Shisius/EyeMeterPCB/Interface/bom_interface_nextpcb.xls

 | Designator* | Quantity* | Manufacturer Part Number* | Manufacturer | Package/Footprint | Description | Procurement Type | Customer Note | HQ Part #
 | Required | Required | Required |  |  |  | Optional 1）Do not populate/install: DNP 2）Customer supplied part: C Learn more >
1 | C1,C2,C3 | 3 | C3216X5R1V226MTJ00E | TDK | 1206 | 22uF |  |  | CA0182043 | https://www.hqonline.com/product-detail/chip-capacitor--mlcc--tdk-c3216x5r1v226mtj00e-2500311338
2 | C4,C14,C29-C49, C54-C64,C82,C90-C92,C94-C96,C99-C102 | 45 | CC0402KRX5R9BB104 | Yageo | _0402 | 0.1uF |  |  | CA0173174 | https://www.hqonline.com/product-detail/chip-capacitor--mlcc--yageo-cc0402krx5r9bb104-2500230851
3 | C5,C11,C51,C68,C73,C74 | 6 | CL10A105KO8NNNC | Samsung | _0603 | 1uF |  |  | CA0000456 | https://www.hqonline.com/product-detail/chip-capacitor--mlcc--samsung-cl10a105ko8nnnc-2500015746
4 | C6,C8 | 2 | CL10A226MP8NUNE | Samsung | _0603 | 22uF |  |  | CA0135462 | https://www.hqonline.com/product-detail/chip-capacitor--mlcc--samsung-cl10a226mp8nune-2500415027
5 | C7 | 1 | - |  |  | 0.1uF | DNP
6 | C9,C10,C13,C88 | 4 | CL10A475KP8NNNC | Samsung | _0603 | 4.7uF |  |  | CA0001809 | https://www.hqonline.com/product-detail/chip-capacitor--mlcc--samsung-cl10a475kp8nnnc-2500015756
7 | C12 | 1 | CL10B332KB8NNNC | Samsung | _0603 | 3.3n |  |  | CA0000169 | https://www.hqonline.com/product-detail/chip-capacitor--mlcc--samsung-cl10b332kb8nnnc-2500216294
8 | C15,C17,C20,C24 | 4 | GRM31CR61A107MEA8L | Murata | 1206 | 100uF |  |  | CA0481664 | https://www.hqonline.com/product-detail/chip-capacitor--mlcc--murata-grm31cr61a107mea8l-2500350836
9 | C16,C18,C22,C27,C97,C98 | 6 | GRM31CR61A476ME15L | Murata | 1206 | 47uF |  |  | CA0135599 | https://www.hqonline.com/product-detail/chip-capacitor--mlcc--murata-grm31cr61a476me15l-2500218741
10 | C19,C21 | 2 | CL10C121JB8NNNC | Samsung | _0603 | 120pF |  |  | CA0000575 | https://www.hqonline.com/product-detail/chip-capacitor--mlcc--samsung-cl10c121jb8nnnc-2500222834
11 | C23,C25,C26,C28,C79,C80,C89,C93 | 8 | CL10A106MP8NNNC | Samsung | _0603 | 10uF |  |  | CA0135232 | https://www.hqonline.com/product-detail/chip-capacitor--mlcc--samsung-cl10a106mp8nnnc-2500414665
12 | C50 | 1 | - |  |  | 10uF | DNP
13 | C52,C53 | 2 | CC0402BRNPO9BN6R8 | Yageo | _0402 | 6.8pF |  |  | CA0161101 | https://www.hqonline.com/product-detail/chip-capacitor--mlcc--yageo-cc0402brnpo9bn6r8-2500237111
14 | C65-C67 | 3 | C3216X5R1E336MT000E | TDK | 1206 | 33u/10V |  |  | CA0182323 | https://www.hqonline.com/product-detail/chip-capacitor--mlcc--tdk-c3216x5r1e336mt000e-2500318962
15 | C69-C72,C75-C78 | 8 | CL05A224KP5NNNC | Samsung | _0402 | 220nF |  |  | CA0000676 | https://www.hqonline.com/product-detail/chip-capacitor--mlcc--samsung-cl05a224kp5nnnc-2500228710
16 | C81,C83-C87 | 6 | CL10A225KP8NNNC | Samsung | _0603 | 2.2uF |  |  | CA0001683 | https://www.hqonline.com/product-detail/chip-capacitor--mlcc--samsung-cl10a225kp8nnnc-2500014133
17 | D1 | 1 | 1N4148WS-7-F | DIODES | SOD-323 | DS0001850 |  |  | DS0001850 | https://www.hqonline.com/product-detail/switching-diodes--small-signal--diodes-1n4148ws-7-f-2500216079
18 | D2-D4,D7,D8 | 5 | PESD5V0S1ULD | Nexperia | SOD882D | CP0019779 |  |  | CP0019779 | https://www.hqonline.com/product-detail/esd-suppressor---tvs-diodes-nexperia-pesd5v0s1uld-315-2500304128
19 | D5,D6 | 2 | B5819WS-TP | MCC | SOD-323 | DS0002831 |  |  | DS0002831 | https://www.hqonline.com/product-detail/schottky-diode-mcc-b5819ws-tp-1023199290
20 | J1 | 1 | 208294-0020 | Molex | SMD | Pico EzMate 1.8mm 2pin |  |  |  | https://www.hqonline.com/product-detail/molex-208294-0020-1025833693
21 | J2 | 1 | 533980271 | Molex | SMD | PicoBlade 2pin Vertical |  |  | ZHLM0039770 | https://www.hqonline.com/product-detail/wire-to-board-connectors-molex-533980271-2500407000
22 | J3,J17 | 2 | 533980671 | Molex | SMD | PicoBlade 6pin Vertical |  |  | ZHLM0308526 | https://www.hqonline.com/product-detail/wire-to-board-connectors-molex-533980671-2500405430
23 | J4,J6,J18 | 3 |  |  |  |  | DNP
24 | J5 | 1 | AFC11-S20ICA-00 | JS | CONN_15.6X3MM_SM | FFC 20pin 0.5mm Vertical |  |  | CO0889517 | https://www.hqonline.com/product-detail/fpc---ffc-connectors-js-afc11-s20ica-00-2500245008
25 | J7,J8 | 2 | 0.5K-AS-20PWB | MSTCONN | CONN_15.65X4.4MM_SM |  |  |  | CO0887814 | https://www.hqonline.com/product-detail/fpc---ffc-connectors-mstconn-0-5k-as-20pwb-2500234409
26 | J9,J12 | 2 | 533980571 | Molex | SMD | PicoBlade 5pin Vertical |  |  | ZHLM0075958 | https://www.hqonline.com/product-detail/wire-to-board-connectors-molex-533980571-2500405775
27 | J10 | 1 | AFA07-S15FCA-00 | JS | CONN_22X5.3MM_SM | FFC 15pin 1.0mm Horizontal |  |  | CO0889558 | https://www.hqonline.com/product-detail/fpc---ffc-connectors-js-afa07-s15fca-00-2500245049
28 | J11 | 1 | HYC77-TF09-200 | 华宇创 | 盘 | Micro SD card socket |  |  | CO0895534 | https://www.hqonline.com/product-detail/sd---sim---tf-card-sockets-hyc-hyc77-tf09-200-1029273652
29 | J13,J14 | 2 | 533980471 | Molex | SMD | PicoBlade 4pin Vertical |  |  | CO0002528 | https://www.hqonline.com/product-detail/wire-to-board-connectors-molex-0533980471-2500221993
30 | J15 | 1 | 533981271 | Molex | SMD | PicoBlade 12pin Vertical |  |  | CO1194767 | https://www.hqonline.com/product-detail/wire-to-board-connectors-molex-533981271-2500394884
31 | J16 | 1 | DF52-5S-0.8H | HRS | P=0.8mm | Hirose 0.8mm 5pin |  |  | CO0908951 | https://www.hqonline.com/product-detail/idc-connectors-hrs-df52-5s-0-8h-21--1007358882
32 | L1,L2 | 2 | DFE252012P-R47M=P2 | Murata | 1008 | 470nH |  |  | IN0020648 | https://www.hqonline.com/product-detail/power-inductors-murata-dfe252012p-r47m=p2-2500415282
33 | L3 | 1 | IHLP4040DZER4R7M11 | Vishay | SMD,10.1x10.8mm | 4.7uH |  |  | IN0021282 | https://www.hqonline.com/product-detail/fixed-inductors-vishay-ihlp4040dzer4r7m11-1008710270
34 | L4,L5 | 2 | XFL4015-471MEC | Coilcraft | SMD,4x4mm | 470nH |  |  | ZHLM0226999 | https://www.hqonline.com/product-detail/power-inductors-coilcraft-xfl4015-471mec-2500415229
35 | R1,R15 | 2 | AC0603FR-07453KL | Yageo | _0603 | 453K |  |  | RE0204828 | https://www.hqonline.com/product-detail/chip-resistors-yageo-ac0603fr-07453kl-2500283017
36 | R2-R4,R42 | 4 |  |  |  |  | DNP
37 | R5,R6,R8,R13,R16,R18,R33 | 7 | AC0603FR-07100KL | Yageo | _0603 | 100K |  |  | RE0034867 | https://www.hqonline.com/product-detail/chip-resistors-yageo-ac0603fr-07100kl-2500274305
38 | R7,R9,R14,R19,R20,R21, R22,R23,R25,R26,R27,R28,R29,R30,R31,R35,R37,R38,R39 | 19 | AC0603FR-0710KL | Yageo | _0603 | 10K |  |  | RE0034865 | https://www.hqonline.com/product-detail/chip-resistors-yageo-ac0603fr-0710kl-2500274307
39 | R10 | 1 | AC0402FR-072R2L | Yageo | _0402 | 2R2 |  |  | RE0203558 | https://www.hqonline.com/product-detail/chip-resistors-yageo-ac0402fr-072r2l-1012707950
40 | R11 | 1 | AC0603FR-0773K2L | Yageo | _0603 | 73.2K |  |  | RE0204883 | https://www.hqonline.com/product-detail/chip-resistors-yageo-ac0603fr-0773k2l-2500283077
41 | R12 | 1 | AC0603FR-07562KL | Yageo | _0603 | 562K |  |  | RE0204850 | https://www.hqonline.com/product-detail/chip-resistors-yageo-ac0603fr-07562kl-2500283042
42 | R17 | 1 | AC0603FR-0775KL | Yageo | _0603 | 75K |  |  | RE0063344 | https://www.hqonline.com/product-detail/chip-resistors-yageo-ac0603fr-0775kl-2500283080
43 | R24 | 1 | CRCW06036K04FKEA | Vishay | _0603 | 6.04K |  |  | RE0046523 | https://www.hqonline.com/product-detail/chip-resistors-vishay-crcw06036k04fkea-2500314244
44 | R32 | 1 | CRCW060347K0FKEA | Vishay | _0603 | 47K |  |  | RE0210203 | https://www.hqonline.com/product-detail/chip-resistors-vishay-crcw060347k0fkea-2500335244
45 | R34 | 1 | AC0603FR-0722RL | Yageo | _0603 | 22R |  |  | RE0063347 | https://www.hqonline.com/product-detail/chip-resistors-yageo-ac0603fr-0722rl-2500274319
46 | R36,R40 | 2 | RTT020000FTH | RALEC | _0402 | 0R |  |  | RE0208784 | https://www.hqonline.com/product-detail/chip-resistors-ralec-rtt020000fth-2500329286
47 | R41 | 1 | RTT030000FTP | RALEC | _0603 | 0R |  |  | RE0207388 | https://www.hqonline.com/product-detail/chip-resistors-ralec-rtt030000ftp-2500320460
48 | U1 | 1 | TPS62480RNCR | TI | VQFN-16(2.5x3) |  |  |  | IC0339798 | https://www.hqonline.com/product-detail/dc-dc-power-supply-chips-ti-tps62480rncr-1009501988
49 | U2 | 1 | SIC438AED-T1-GE3 | Vishay | PowerPAK-MLP44-24L |  |  |  | PM0148764 | https://www.hqonline.com/product-detail/dc-dc-power-supply-chips-vishay-sic438aed-t1-ge3-1021199767
50 | U3,U4 | 2 | TPS62823DLCR | TI | QFN (8) |  |  |  | PM0174636 | https://www.hqonline.com/product-detail/dc-dc-power-supply-chips-ti-tps62823dlcr-2500408658
51 | U5 | 1 | W25Q128FVSIG | Winbond | SOIC8_208MIL |  |  |  | IC0142197 | https://www.hqonline.com/product-detail/flash-memories-winbond-w25q128fvsig-2500289322
52 | U6 | 1 | VL805-Q6 | VIA Labs | QFN68 8x8 mm
53 | U7 | 1 | TPS2062DR | TI | SOIC8 |  |  |  | IC0273860 | https://www.hqonline.com/product-detail/power-switches---load-switches-ti-tps2062dr-1-1014202762
54 | U8-U13,U16,U20-U23,U25 | 12 | TPD4E02B04DQAR | TI | USON-10 |  |  |  | CP0003956 | https://www.hqonline.com/product-detail/esd-suppressor---tvs-diodes-ti-tpd4e02b04dqar-1036113975
55 | U14,U15,U19,U26 | 4 | TPD4E05U06DQAR | TI | USON10_2.5X1MM |  |  |  | CP0003927 | https://www.hqonline.com/product-detail/esd-suppressor---tvs-diodes-ti-tpd4e05u06dqar-2500216963
56 | U17 | 1 | CS42L42-CNZR | Cirrus Logic | 48-pin QFN
57 | U18 | 1 | TPD1E05U06DPYR | TI | X1SON2_1X0.6MM |  |  |  | CP0003571 | https://www.hqonline.com/product-detail/esd-suppressor---tvs-diodes-ti-tpd1e05u06dpyr-2500288724
58 | U24 | 1 | TPS2061CDBVR | TI | SOT-23-5 |  |  |  | IC0279848 | https://www.hqonline.com/product-detail/power-switches---load-switches-ti-tps2061cdbvr-1002595270
59 | U27 | 1 | TXS0102DQE | TI | X2SON8_1.4X1MM |  |  |  | IC0132488 | https://www.hqonline.com/product-detail/translators--level-shifters-ti-txs0102dqer-2500345757
60 | U28 | 3 | DF40C-100DS-0.4V(51) | HRS | CONN_22.6X2.88_SM | Hirose 100pin CM5
61 | Y1 | 1 | ECS-250-8-33B-CTN-TR | ECS Inc. | 3.2 x 2.5 x 0.8 mm |  |  |  | CR0312679
