Shisius/EyeMeterPCB/Interface/interface.kicad_sch

## KiCad design Interface/interface.kicad_sch (2025-08-15)

Schematic: interface.kicad_sch

Parts:
C1, C2, C3: 22u/35V; C_1206_3216Metric_Pad1.33x1.80mm_HandSolder
C4, C14, C29, C30, C31, C32, C33, C34, C35, C36, C37, C38, C39, C40, C41, C46, C47, C48, C49, C54, C63, C64: 0.1u; C_0402_1005Metric_Pad0.74x0.62mm_HandSolder
C5, C11, C51: 1u; C_0603_1608Metric_Pad1.08x0.95mm_HandSolder
C6, C8: 22u; C_0603_1608Metric_Pad1.08x0.95mm_HandSolder
C7: 0.1u; C_0402_1005Metric_Pad0.74x0.62mm_HandSolder; not fitted
C9, C10, C13: 4.7u; C_0603_1608Metric_Pad1.08x0.95mm_HandSolder
C12: 3.3n; C_0603_1608Metric_Pad1.08x0.95mm_HandSolder
C15, C17, C20, C24: 100u; C_1206_3216Metric_Pad1.33x1.80mm_HandSolder
C16, C18, C22, C27: 47u; C_1206_3216Metric_Pad1.33x1.80mm_HandSolder
C19, C21: 120p; C_0603_1608Metric_Pad1.08x0.95mm_HandSolder
C23, C25, C26, C28: 10u; C_0603_1608Metric_Pad1.08x0.95mm_HandSolder
C42, C43, C44, C45, C55, C56, C57, C58, C59, C60, C61, C62: 0.1u; C_0402_1005Metric
C50: 10u; C_0603_1608Metric_Pad1.08x0.95mm_HandSolder; not fitted
C52, C53: 6.8p; C_0402_1005Metric_Pad0.74x0.62mm_HandSolder
C65, C66, C67: 33u/10V; C_1206_3216Metric_Pad1.33x1.80mm_HandSolder
D1: 1N4148WS; D_SOD-323
D2, D3, D4: PESD5V0S1ULD; D_SOD-882D
J1: Conn_01x02_Pin; Molex_Pico-EZmate_208294-0002_1x02-1MP_P1.80mm
J2: Conn_01x02_Pin; Molex_PicoBlade_53398-0271_1x02-1MP_P1.25mm_Vertical
J3: Conn_01x06_Pin; Molex_PicoBlade_53398-0671_1x06-1MP_P1.25mm_Vertical
J4: USB3_IPEX
J5: Conn_01x20_Pin; JUSHUO_AFC11-S20ICA-00_1x20-1MP_P0.5mm_Vertical
J6: Conn_01x19_Pin; VUSB3-V-TH-19-MBH_VALCON; not fitted
L1, L2: 470n; L_1008_2520Metric_Pad1.43x2.20mm_HandSolder
L3: 4.7u; L_Vishay_IHLP-4040
L4, L5: 470n; L_Coilcraft_XFL4015
R1: 453K?; R_0603_1608Metric_Pad0.98x0.95mm_HandSolder
R2, R4: 100k; R_0603_1608Metric_Pad0.98x0.95mm_HandSolder; not fitted
R3: 2.8k; R_0603_1608Metric_Pad0.98x0.95mm_HandSolder; not fitted
R5, R6: 100k; R_0603_1608Metric_Pad0.98x0.95mm_HandSolder
R7, R9, R19, R20, R21, R22, R23, R25, R26, R27, R28: 10K; R_0603_1608Metric_Pad0.98x0.95mm_HandSolder
R8, R13, R16, R18: 100K; R_0603_1608Metric_Pad0.98x0.95mm_HandSolder
R10: 2R2; R_0402_1005Metric_Pad0.72x0.64mm_HandSolder
R11: 73.2k; R_0603_1608Metric_Pad0.98x0.95mm_HandSolder
R12: 562K; R_0603_1608Metric_Pad0.98x0.95mm_HandSolder
R14: 10k; R_0603_1608Metric_Pad0.98x0.95mm_HandSolder
R15: 453K; R_0603_1608Metric_Pad0.98x0.95mm_HandSolder
R17: 75K; R_0603_1608Metric_Pad0.98x0.95mm_HandSolder
R24: 6.04K; R_0603_1608Metric_Pad0.98x0.95mm_HandSolder
U1: TPS62480; TPS62480_VQFN
U2: SIC438B; Vishay_PowerPAK_MLP44-24L_ThermalVias
U3, U4: TPS62823DLC; Texas_VSON-HR-8_1.5x2mm_P0.5mm
U5: W25Q128FVS; SOIC-8W_5.3x5.3mm_P1.27mm
U6: VL805; QFN-68-1EP_8x8mm_P0.4mm_EP5.2x5.2mm_ThermalVias
U7: TPS2062; SOIC-8_3.9x4.9mm_P1.27mm_HandSoldering
U8, U9, U10, U11, U12, U13: TPD4E02B04DQA/ESD73034D; USON-10_2.5x1.0mm_P0.5mm
Y1: Crystal_GND24; Crystal_SMD_3225-4Pin_3.2x2.5mm_HandSoldering

Connections:
+1.05V: C21.1, C26.1, C28.1, C30.1, C32.1, C35.1, C37.1, C39.1, C41.1, C47.1, C49.1, L5.2, R17.2, U6.3 (VCCA10SSRX34), U6.9 (VDD), U6.12 (VCCA10SSRX34), U6.29 (VDD), U6.45 (VDD), U6.54 (VCCA10SSRX12), U6.60 (VDD), U6.63 (VCCA10SSRX12)
+3.3V: C9.1, C19.1, C23.1, C25.1, C29.1, C31.1, C33.1, C34.1, C36.1, C38.1, C40.1, C46.1, C48.1, D1.1 (K), L4.2, R9.1, R15.2, R19.1, R20.1, R21.1, R22.1, R23.1, R25.1, R26.1, R27.1, R28.1, U4.7 (VIN), U5.8 (VCC), U6.6 (VCCA33SS34), U6.15 (VCCA33SS34), U6.23 (VCCA33PEX), U6.32 (VSUS33), U6.46 (VSUS33), U6.49 (VCCA33SSM), U6.57 (VCCA33SS12), U6.66 (VCCA33SS12)
+3.3V_RADXA: R1.2, R7.1
+4V: C10.1, C16.1, C18.1, C22.1, C27.1, L1.2, L2.2, R12.2, U1.16 (VO), U3.7 (VIN)
+5V: C6.1, C8.1, C15.1, C17.1, C20.1, C24.1, C54.1, J3.1, J3.2, J3.3, L3.2, R11.1, U1.3 (VIN1), U1.4 (EN), U1.9 (VIN2), U2.18 (V_{OUT}), U7.2 (IN)
EN: C7.1, J2.2, R2.2, R3.1, U2.19 (EN)
GND: C1.2, C2.2, C3.2, C4.2, C5.2, C6.2, C7.2, C8.2, C9.2, C10.2, C11.2, C12.2, C13.2, C15.2, C16.2, C17.2, C18.2, C20.2, C22.2, C23.2, C24.2, C25.2, C26.2, C27.2, C28.2, C29.2, C30.2, C31.2, C32.2, C33.2, C34.2, C35.2, C36.2, C37.2, C38.2, C39.2, C40.2, C41.2, C46.2, C47.2, C48.2, C49.2, C50.1, C51.2, C52.2, C53.2, C54.2, C63.2, C64.2, C65.2, C66.2, C67.2, D2.2 (A), D3.2 (A), D4.2 (A), J1.1, J3.4, J3.5, J3.6, J4.5 (GND), J4.8 (GND), J4.11 (GND), J4.12 (GND), J4.13 (GND), J4.14 (GND), J4.15 (GND), J4.16 (GND), J4.17 (GND), J5.9, J5.10, J5.15, J5.20, J6.4, J6.7, J6.10, J6.13, J6.16, R3.2, R5.2, R8.1, R13.1, R14.2, R16.1, R18.1, R24.2, U1.1 (PGND1), U1.5 (PG), U1.6 (VSEL), U1.8 (MODE), U1.11 (PGND2), U1.13 (AGND), U2.3 (P_{GND}), U2.4 (P_{GND}), U2.13 (P_{GND}), U2.16 (A_{GND}), U2.25 (A_{GND}), U2.27 (P_{GND}), U3.3 (AGND), U3.5 (PGND), U3.8 (PG), U4.3 (AGND), U4.5 (PGND), U4.8 (PG), U5.4 (GND), U6.69 (GNDPAD), U7.1 (GND), U8.3 (G), U8.8 (G), U9.3 (G), U9.8 (G), U10.3 (G), U10.8 (G), U11.3 (G), U11.8 (G), U12.3 (G), U12.8 (G), U13.3 (G), U13.8 (G), Y1.2, Y1.4
unnamed: C5.1, R4.1, R6.1, U2.15 (V_{DD})
unnamed: C11.1, R9.2, U4.1 (EN)
unnamed: C12.1, U1.12 (SS/TR)
unnamed: C13.1, U2.12 (V_{DRV})
unnamed: C14.1, U2.23 (BOOT)
unnamed: C14.2, R10.2
unnamed: C19.2, R15.1, R16.2, U3.2 (FB)
unnamed: C21.2, R17.1, R18.2, U4.2 (FB)
unnamed: C51.1, D1.2 (A), R23.2, U6.31 (PONRST#)
unnamed: C52.1, U6.47 (SSXI), Y1.1
unnamed: C53.1, U6.48 (SSXO), Y1.3
unnamed: L1.1, U1.2 (SW1)
unnamed: L2.1, U1.10 (SW2)
unnamed: L3.1, U2.5 (SW), U2.6 (SW), U2.7 (SW), U2.8 (SW), U2.9 (SW)
unnamed: L4.1, U3.6 (SW)
unnamed: L5.1, U4.6 (SW)
unnamed: R4.2, R5.1, U2.21 (MODE1)
unnamed: R6.2, U2.20 (MODE2)
unnamed: R7.2, R8.2, U3.1 (EN)
unnamed: R10.1, U2.24 (PHASE)
unnamed: R11.2, R14.1, U2.17 (FB)
unnamed: R12.1, R13.2, U1.14 (FB)
unnamed: R19.2, U5.7 (~HOLD/~RESET(IO_{3}))
unnamed: R20.2, U5.3 (~WP(IO_{2}))
unnamed: R21.2, U6.20 (PEXWAKE#)
unnamed: R22.2, U6.18 (SMI#)
unnamed: R24.1, U6.50 (SSREXT)
unnamed: U2.10 (GL), U2.11 (GL), U2.28 (GL)
unnamed: U5.1 (~CS), U6.34 (SPICS#)
unnamed: U5.2 (DO(IO_{1})), U6.33 (SPISO)
unnamed: U5.5 (DI(IO_{0})), U6.36 (SPISI)
unnamed: U5.6 (CLK), U6.35 (SPISCLK)
PCIe_CLK+: U6.21 (PEXCLK+)
PCIe_CLK-: U6.22 (PEXCLK-)
PCIe_CLK_nREQ: U6.30 (PEXCREQ#)
PCIe_RX+: C44.1
PCIe_RX-: C42.1
PCIe_TX+: C45.1
PCIe_TX-: C43.1
PCIe_nRST: C50.2, U6.19 (PEXRST#)
PEXRX0_CAP+: C45.2, U6.27 (PEXRX0+)
PEXRX0_CAP-: C43.2, U6.28 (PEXRX0-)
PEXTX0_CAP+: C44.2, U6.24 (PEXTX0+)
PEXTX0_CAP-: C42.2, U6.25 (PEXTX0-)
PG: J2.1, U2.14 (P_{GOOD})
SSRX1+: J5.13, J5.14, U6.55 (SSRX1+), U8.4 (IO3), U8.7 (NC)
SSRX1-: J5.11, J5.12, U6.56 (SSRX1-), U8.5 (IO4), U8.6 (NC)
SSRX2+: J4.7 (SSRX+), U6.64 (SSRX2+), U13.1 (IO1), U13.10 (NC)
SSRX2-: J4.6 (SSRX-), U6.65 (SSRX2-), U13.2 (IO2), U13.9 (NC)
SSRX3+: J6.2, U6.4 (SSRX3+), U10.4 (IO3), U10.7 (NC)
SSRX3-: J6.3, U6.5 (SSRX3-), U10.5 (IO4), U10.6 (NC)
SSRX4+: J6.17, U6.13 (SSRX4+), U12.1 (IO1), U12.10 (NC)
SSRX4-: J6.18, U6.14 (SSRX4-), U12.2 (IO2), U12.9 (NC)
SSTX1+: C55.2, J5.18, J5.19, U8.1 (IO1), U8.10 (NC)
SSTX1-: C59.2, J5.16, J5.17, U8.2 (IO2), U8.9 (NC)
SSTX1_CAP+: C55.1, U6.52 (SSTX1+)
SSTX1_CAP-: C59.1, U6.53 (SSTX1-)
SSTX2+: C56.2, J4.10 (SSTX+), U9.4 (IO3), U9.7 (NC)
SSTX2-: C60.2, J4.9 (SSTX-), U9.5 (IO4), U9.6 (NC)
SSTX2_CAP+: C56.1, U6.61 (SSTX2+)
SSTX2_CAP-: C60.1, U6.62 (SSTX2-)
SSTX3+: C57.2, J6.5, U10.1 (IO1), U10.10 (NC)
SSTX3-: C61.2, J6.6, U10.2 (IO2), U10.9 (NC)
SSTX3_CAP+: C57.1, U6.1 (SSTX3+)
SSTX3_CAP-: C61.1, U6.2 (SSTX3-)
SSTX4+: C58.2, J6.14, U11.4 (IO3), U11.7 (NC)
SSTX4-: C62.2, J6.15, U11.5 (IO4), U11.6 (NC)
SSTX4_CAP+: C58.1, U6.10 (SSTX4+)
SSTX4_CAP-: C62.1, U6.11 (SSTX4-)
TG_4VDCDC: R1.1, U1.7 (TG)
USB2D1+: J5.7, J5.8, U6.58 (USB2D1+), U9.1 (IO1), U9.10 (NC)
USB2D1-: J5.5, J5.6, U6.59 (USB2D1-), U9.2 (IO2), U9.9 (NC)
USB2D2+: J4.4 (D+), U6.67 (USB2D2+), U13.4 (IO3), U13.7 (NC)
USB2D2-: J4.3 (D-), U6.68 (USB2D2-), U13.5 (IO4), U13.6 (NC)
USB2D3+: J6.9, U6.7 (USB2D3+), U11.1 (IO1), U11.10 (NC)
USB2D3-: J6.8, U6.8 (USB2D3-), U11.2 (IO2), U11.9 (NC)
USB2D4+: J6.11, U6.16 (USB2D4+), U12.4 (IO3), U12.7 (NC)
USB2D4-: J6.12, U6.17 (USB2D4-), U12.5 (IO4), U12.6 (NC)
USBEN1: R25.2, U6.42 (USBHPE2#), U6.44 (USBHPE1#), U7.3 (~EN1)
USBEN2: R26.2, U6.38 (USBHPE4#), U6.40 (USBHPE3#), U7.4 (~EN2)
USBOC1: R28.2, U6.41 (USBHOC2#), U6.43 (USBHOC1#), U7.8 (~OC1)
USBOC2: R27.2, U6.37 (USBHOC4#), U6.39 (USBHOC3#), U7.5 (~OC2)
VBAT: C1.1, C2.1, C3.1, C4.1, J1.2, R2.1, U2.1 (V_{IN}), U2.2 (V_{IN}), U2.22 (V_{IN}), U2.26 (V_{IN})
VBUS1: C64.1, C65.1, C66.1, D2.1 (K), D3.1 (K), J4.1 (VBUS), J4.2 (VBUS), J5.1, J5.2, J5.3, J5.4, U7.7 (OUT1)
VBUS2: C63.1, C67.1, D4.1 (K), J6.1, J6.19, U7.6 (OUT2)

Notes on the sheet:
C_{AC-COUPLING} = (75-200)nF Close to U
3.3V
(3A=>50mil=1.27mm)
FCCM
or +5V
(1080 glass style) 0.0022", (2116 glass style) 0.0042", (7628 glass style) 0.0075”
6.5A
PCIe_1V05 is delayed by 10ms than DCDC_3V3 to start
CL10A106KQ8NNNC
+3.3V
Match the differential SS pair trace lengths within 0.12 mm (5 mils). Match the Hi-Speed (D+ and D–) signal trace lengths within 1.25 mm (50 mils). Adjust the Hi-Speed signal trace lengths near the USB receptacle, if necessary. Make adjustments for SS Rx signal trace lengths near the USB recept…
500kHz
PCIdif=100 Ohm
(5A=>110mil=2.794mm)
5A/pin
TESTEN - Test Mode Enable Do not connect for normal operation. Internal pull down.
Roger is the favorite dielectric material due to its low DK and DF value, low price, and less signal loss. FR-4 is only suitable for 1 GHz to 10 GHz frequency. In terms of DF(dielectric loss), DK (dielectric constant), and water absorption, Teflon is the best, but more expensive than FR-4. The Tefl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
Prepreg dielectric constant: 4.2
spacing between traces of adjacent pairs must be at least 20 mils edge-to-edge
4mA
150mil=3.8mm
Every effort should be made to avoid vias on the PCIe differential pairs since they can result in a signal loss of up to 0.25 dB. When a via is unavoidable, its pad size should be less than 25 mils, its hole size should be less than 14 mils and its anti-pads should be 35 mils or smaller
VOD: 0.0 - 0.3 V VOH: 2.8 - 3.6 V
The degradation does not stem from the via itself, but from the act of layer changing. To avoid this problem on a four-layer PCB, the signals must start and end on the same signal layer and not pass through to the other signal layer.
Interface board 1. pins 102-124 - VL805 - to ffc 20 pin 0.5 2. HDMI0 ffc 20 pin 0.5 3. DSI0 ffc 15 pin 1.0 4. RTC - 10. Ethernet rj45 (optional)
54%Ilimit (6.5A) SS=6ms
+4V
FR-4 has a higher ability to absorb water. Hence, it is better to use FR-4 for circuits where moisture could be a problem.
Vin=4.5...28V
Two immediate planes underneath the AC coupling capacitors should have a cutout in the shape of these capacitors to avoid extra capacitance on the lines created by the capacitor pads.
prepregtype: 7628/1080/2313/2116
USB HUB VL805
Ven=2...5.5V
VTX-CM = 0 - 3.6 V ZTX = ZRX = 50 Ohms CTX = 75 – 200 nF
+5V
regular FR4 material is appropriate dielectric material
Skip
The differential characteristic impedance for the SDP pairs is recommended to be within 90 Ω +/- 7 Ω.
It is recommended that the length of the SS PCB traces be kept under 11 inches.
FR-4 has a higher TCDK compared to high-frequency lamination, which makes it incapable of using in circuits that require little variation over a wide range of temperatures.
VEN_H>1.6V
