Shisius/EyeMeterPCB/Interface/list2.kicad_sch

## KiCad design Interface/list2.kicad_sch (2025-08-15)

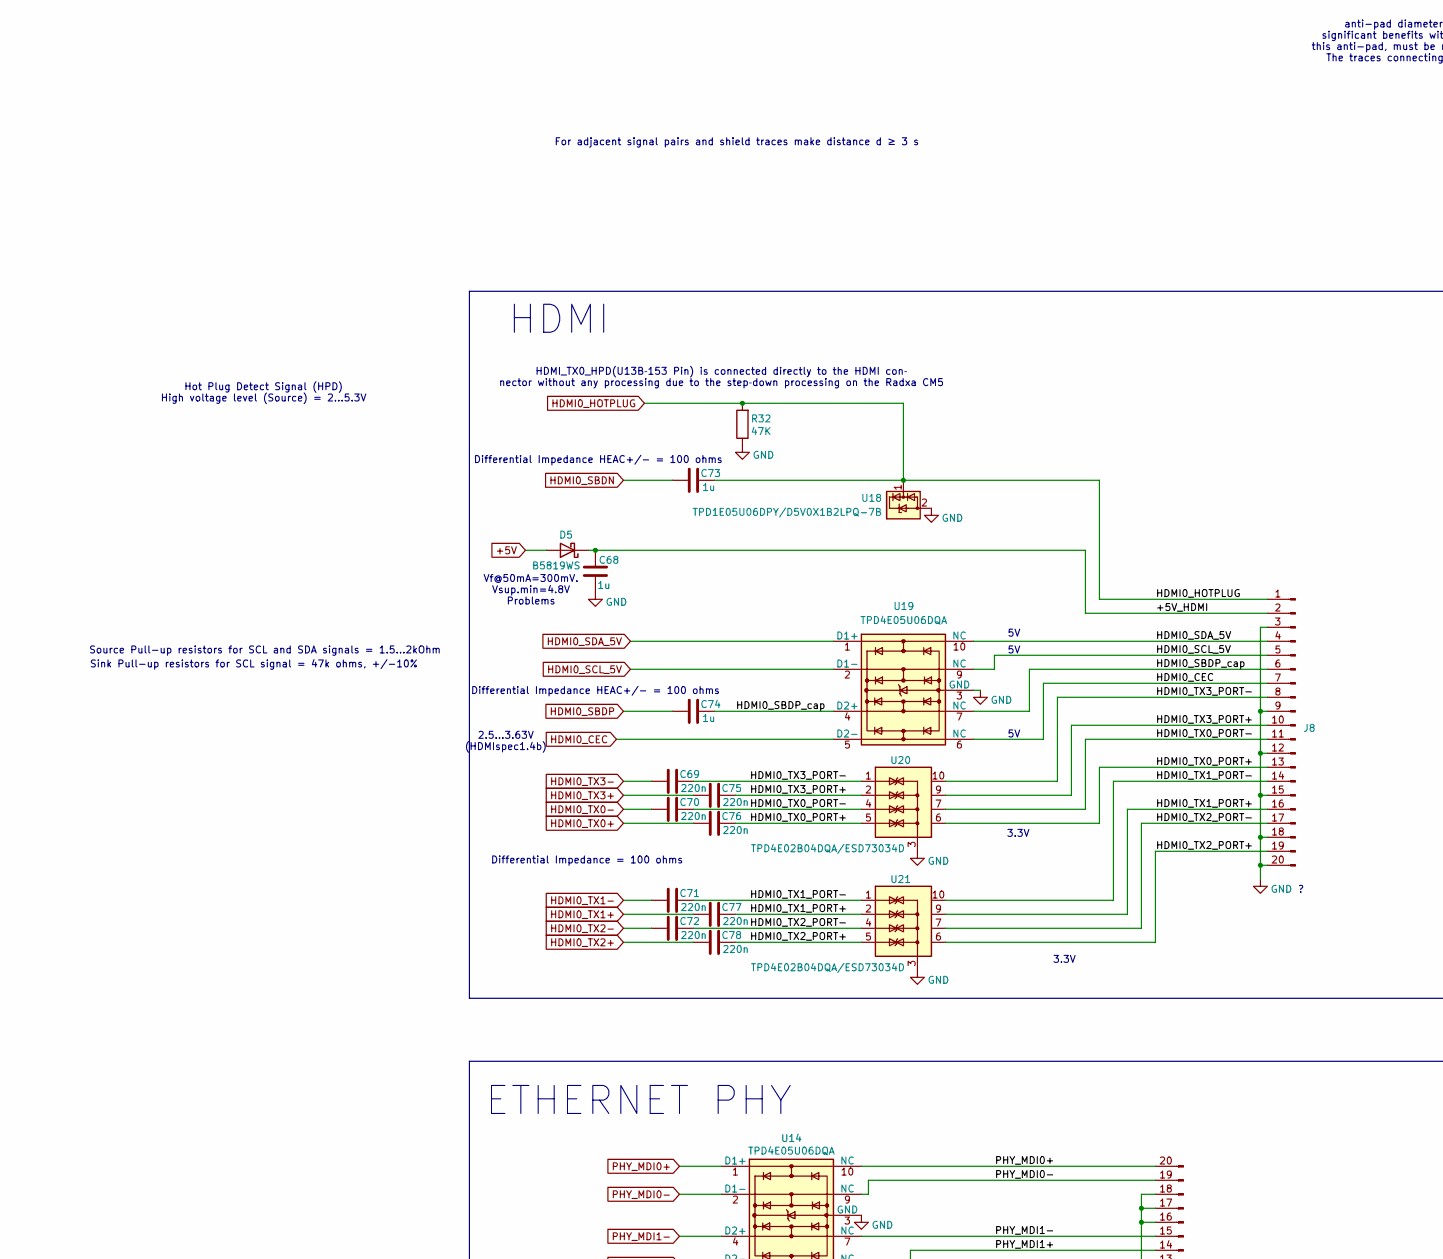
[picture p1: schematic list2.kicad_sch, part in row 1, column 1]

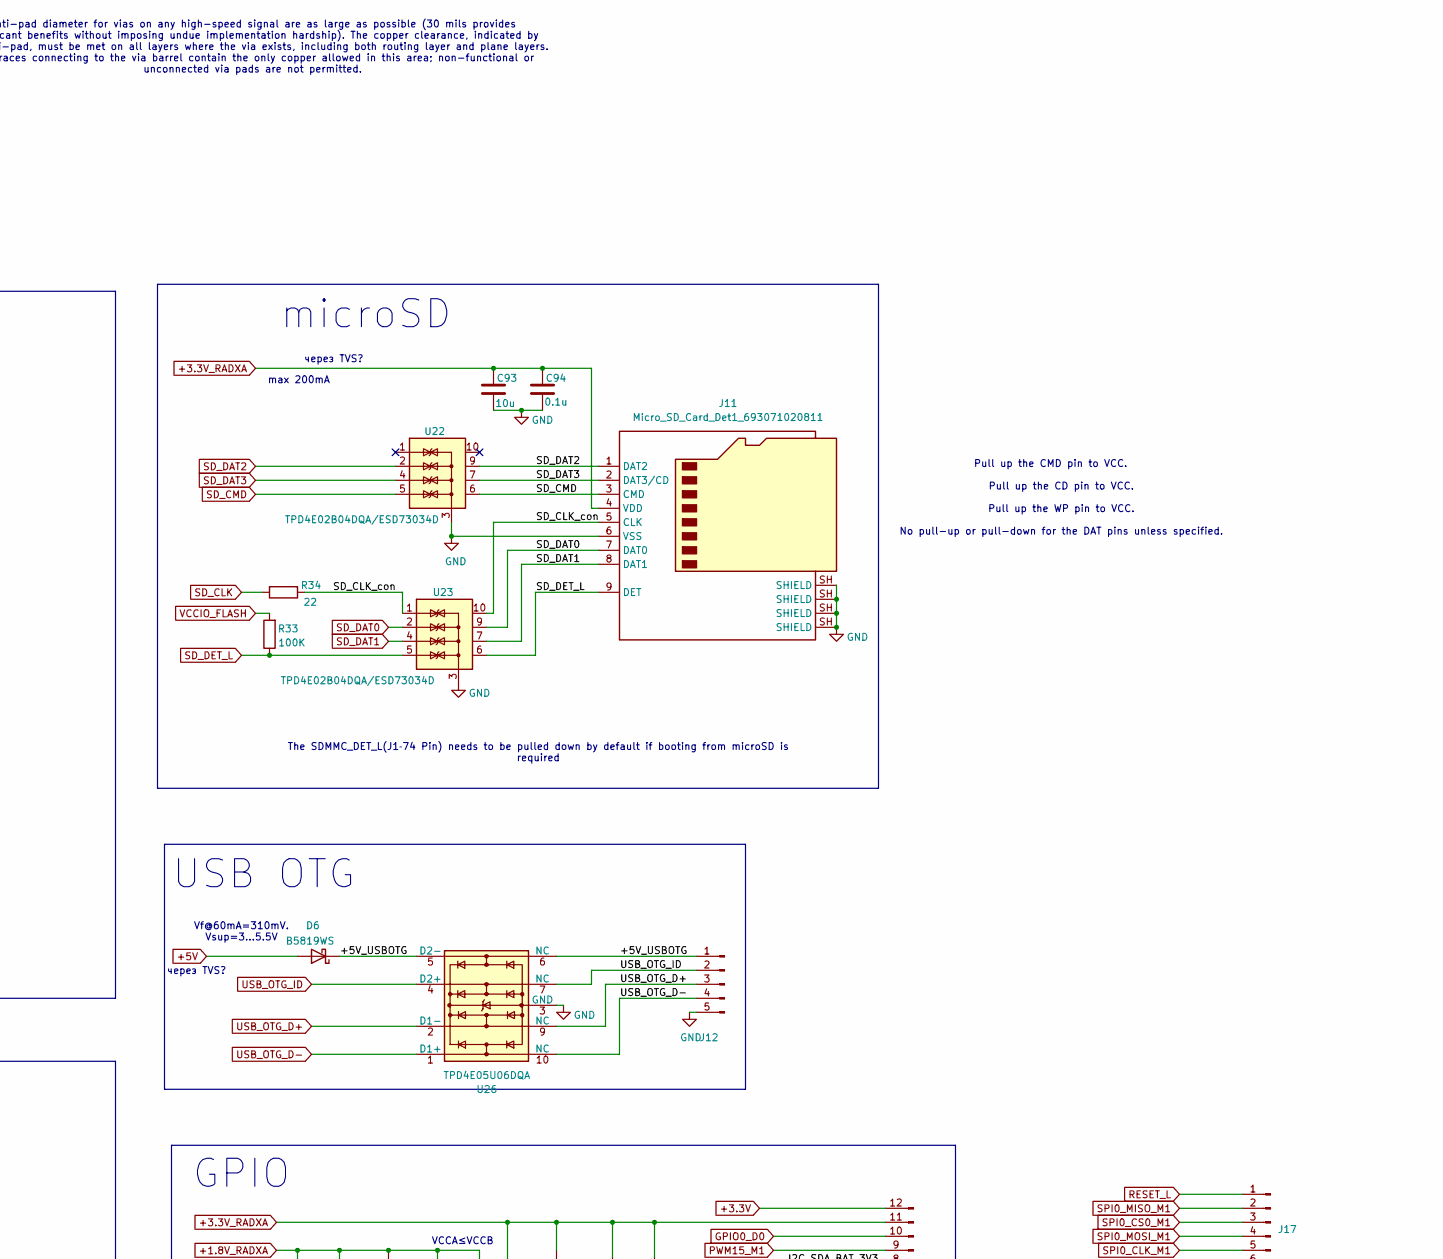
[picture p2: schematic list2.kicad_sch, part in row 1, column 2]

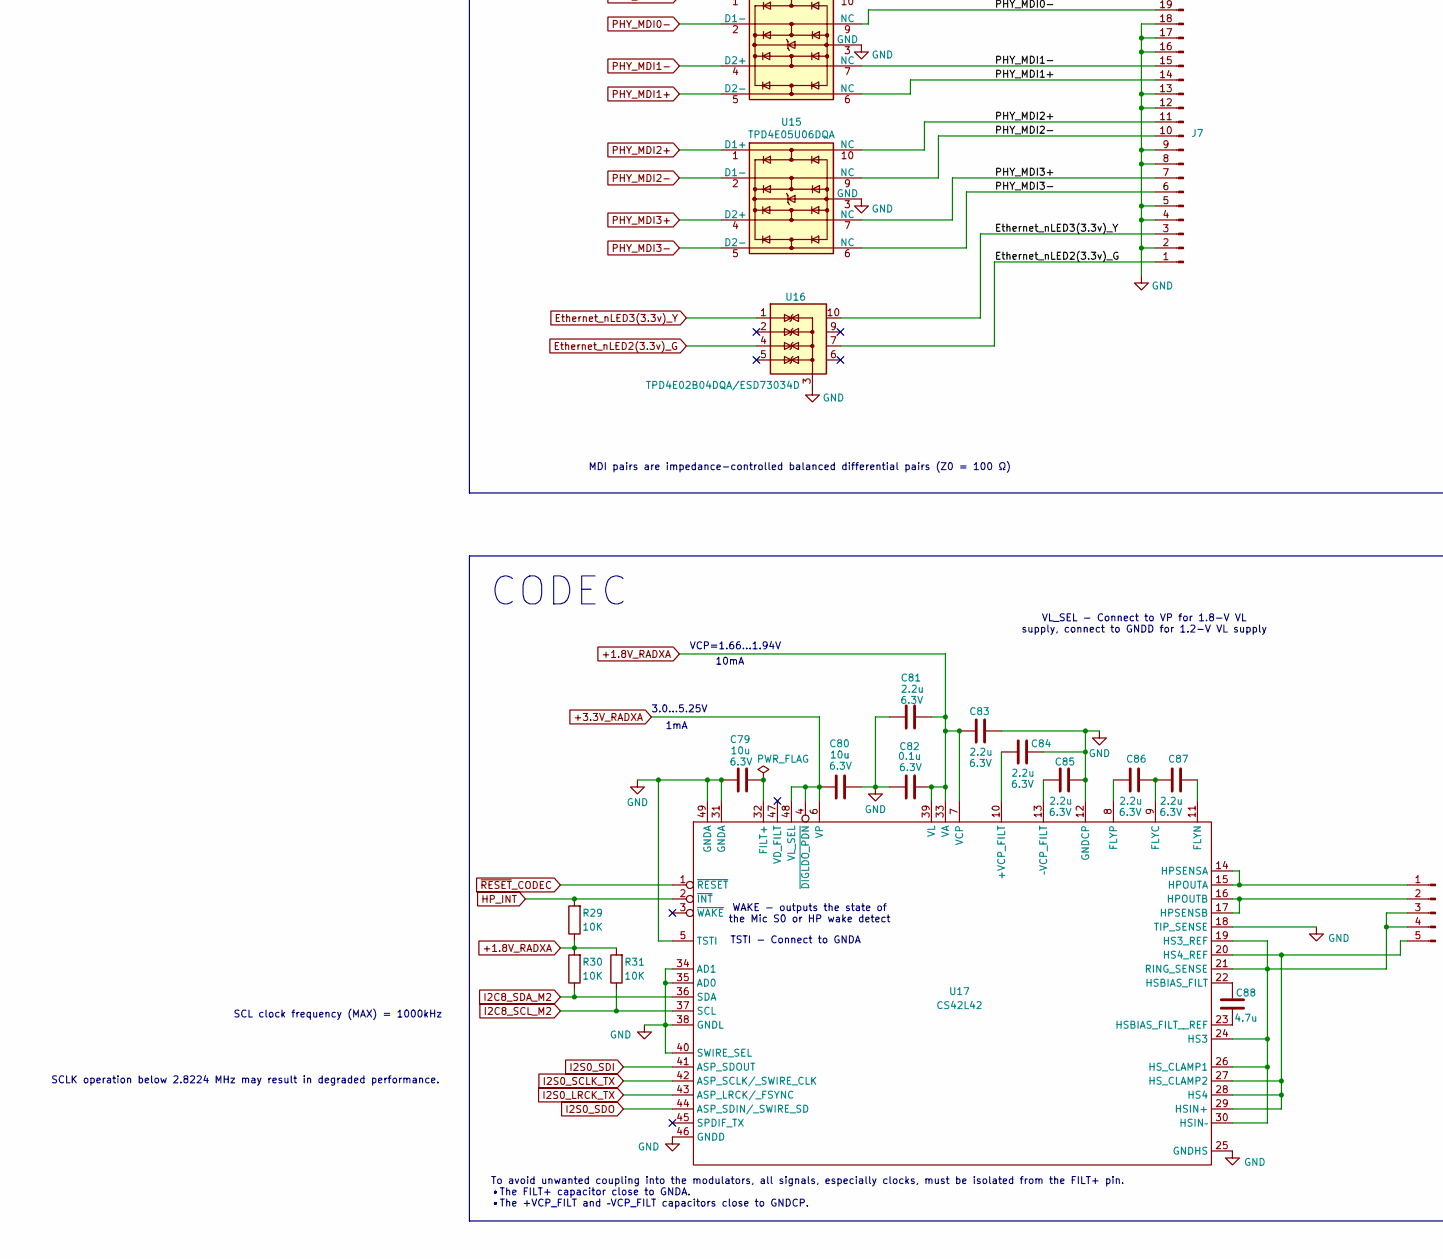
[picture p3: schematic list2.kicad_sch, part in row 2, column 1]

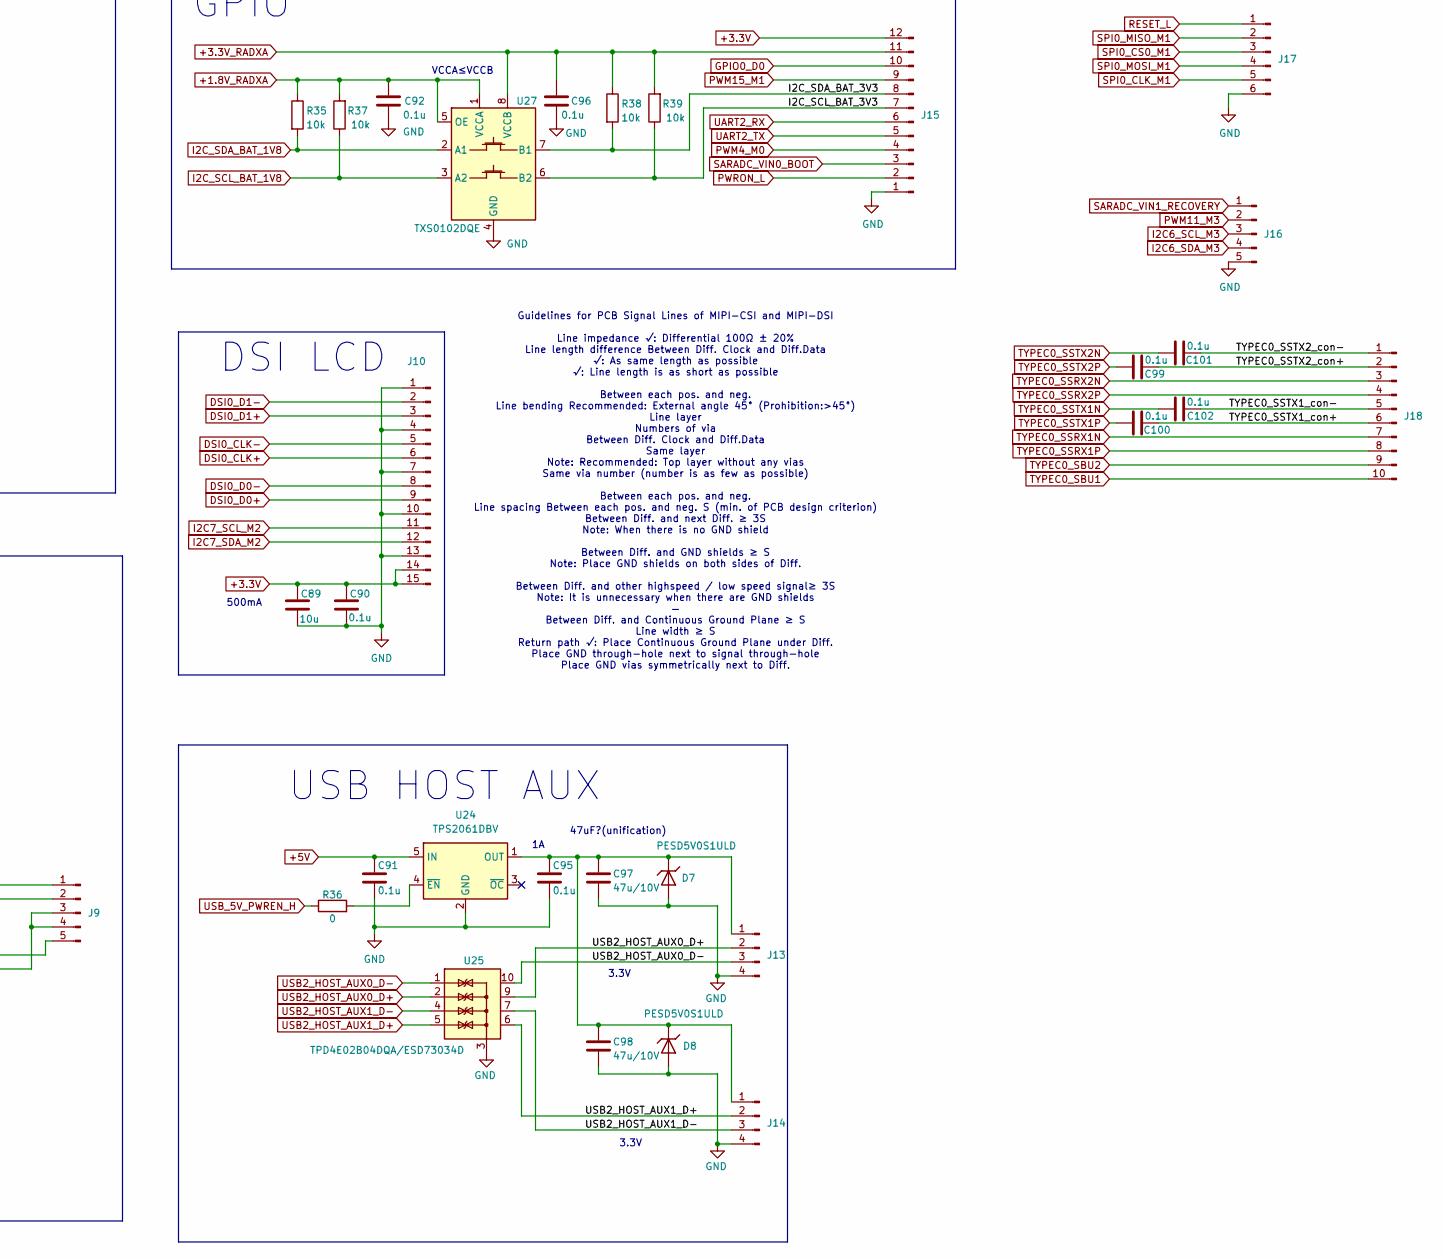
[picture p4: schematic list2.kicad_sch, part in row 2, column 2]

Parts:
C68, C73, C74: 1u; C_0603_1608Metric_Pad1.08x0.95mm_HandSolder
C69, C70, C71, C72, C75, C76, C77, C78: 220n; C_0402_1005Metric
C79, C80: 10u; C_0603_1608Metric_Pad1.08x0.95mm_HandSolder; Voltage 6.3V
C81, C83, C84, C85, C86, C87: 2.2u; C_0603_1608Metric_Pad1.08x0.95mm_HandSolder; Voltage 6.3V
C82: 0.1u; C_0402_1005Metric_Pad0.74x0.62mm_HandSolder; Voltage 6.3V
C88: 4.7u; C_0603_1608Metric_Pad1.08x0.95mm_HandSolder
C89, C93: 10u; C_0603_1608Metric_Pad1.08x0.95mm_HandSolder
C90, C91, C92, C94, C95, C96: 0.1u; C_0402_1005Metric_Pad0.74x0.62mm_HandSolder
C97, C98: 47u/10V; C_1206_3216Metric_Pad1.33x1.80mm_HandSolder
C99, C100, C101, C102: 0.1u; C_0402_1005Metric
D5, D6: B5819WS; D_SOD-323
D7, D8: PESD5V0S1ULD; D_SOD-882D
J7, J8: Conn_01x20_Pin; MSTCONN_0.5K-AS-20PWB
J9, J12: Conn_01x05_Pin; Molex_PicoBlade_53398-0571_1x05-1MP_P1.25mm_Vertical
J10: Conn_01x15_Pin; JUSHUO_AFA07-S15FCA-00_1x15-1MP_P1.0mm_Horizontal
J11: Micro_SD_Card_Det1_693071020811; J_SD_Card-micro_socket_A
J13, J14: Conn_01x04_Pin; Molex_PicoBlade_53398-0471_1x04-1MP_P1.25mm_Vertical
J15: Conn_01x12_Pin; Molex_PicoBlade_53398-1271_1x12-1MP_P1.25mm_Vertical
J16: Conn_01x05_Pin; Hirose_DF52-5S-0.8H_1x05-1MP_P0.80mm_Horizontal
J17: Conn_01x06_Pin; Molex_PicoBlade_53398-0671_1x06-1MP_P1.25mm_Vertical
J18: Conn_01x10_Pin; TE_1-1734839-0_1x10-1MP_P0.5mm_Horizontal
R29, R30, R31: 10K; R_0603_1608Metric_Pad0.98x0.95mm_HandSolder
R32: 47K; R_0603_1608Metric_Pad0.98x0.95mm_HandSolder
R33: 100K; R_0603_1608Metric_Pad0.98x0.95mm_HandSolder
R34: 22; R_0603_1608Metric_Pad0.98x0.95mm_HandSolder
R35, R37, R38, R39: 10k; R_0603_1608Metric_Pad0.98x0.95mm_HandSolder
R36: 0; R_0402_1005Metric_Pad0.72x0.64mm_HandSolder
U14, U15, U19, U26: TPD4E05U06DQA; USON-10_2.5x1.0mm_P0.5mm
U16, U20, U21, U22, U23, U25: TPD4E02B04DQA/ESD73034D; USON-10_2.5x1.0mm_P0.5mm
U17: CS42L42; QFN-48-1EP_6x6mm_P0.4mm_EP4.3x4.3mm_ThermalVias
U18: TPD1E05U06DPY/D5V0X1B2LPQ-7B; Texas_DPY0002A_0.6x1mm_P0.65mm
U24: TPS2061DBV; TSOT-23-5
U27: TXS0102DQE; X2SON-8_1.4x1mm_P0.35mm

Connections:
+1.8V_RADXA: C81.2, C82.2, C83.1, C92.1, R29.1, R30.2, R31.2, R35.1, R37.2, U17.7 (VCP), U17.33 (VA), U17.39 (VL), U27.1 (VCCA), U27.5 (OE)
+3.3V: C89.1, C90.1, J10.14, J10.15, J15.12
+3.3V_RADXA: C80.1, C93.1, C94.1, C96.1, J11.4 (VDD), J15.11, R38.1, R39.2, U17.4 (~DIGLDO_PDN), U17.6 (VP), U17.48 (VL_SEL), U27.8 (VCCB)
+5V: C91.1, D5.2 (A), D6.2 (A), U24.5 (IN)
+5V_HDMI: C68.1, D5.1 (K), J8.2
+5V_USBOTG: D6.1 (K), J12.1, U26.5 (D2-), U26.6 (NC)
DSI0_CLK+: J10.6
DSI0_CLK-: J10.5
DSI0_D0+: J10.9
DSI0_D0-: J10.8
DSI0_D1+: J10.3
DSI0_D1-: J10.2
Ethernet_nLED2(3.3v)_G: J7.1, U16.4 (IO3), U16.7 (NC)
Ethernet_nLED3(3.3v)_Y: J7.3, U16.1 (IO1), U16.10 (NC)
GND: C68.2, C79.1, C80.2, C81.1, C82.1, C83.2, C84.2, C85.2, C89.2, C90.2, C91.2, C92.2, C93.2, C94.2, C95.2, C96.2, C97.2, C98.2, D7.2 (A), D8.2 (A), J7.2, J7.4, J7.5, J7.8, J7.9, J7.12, J7.13, J7.16, J7.17, J7.18, J8.3, J8.9, J8.12, J8.15, J8.18, J8.20, J10.1, J10.4, J10.7, J10.10, J10.13, J11.6 (VSS), J11.SH (SHIELD), J12.5, J13.4, J14.4, J15.1, J16.5, J17.6, R32.1, U14.3 (GND), U14.8 (GND), U15.3 (GND), U15.8 (GND), U16.3 (G), U16.8 (G), U17.5 (TSTI), U17.12 (GNDCP), U17.18 (TIP_SENSE), U17.25 (GNDHS), U17.31 (GNDA), U17.34 (AD1), U17.35 (AD0), U17.38 (GNDL), U17.40 (SWIRE_SEL), U17.46 (GNDD), U17.49 (GNDA), U18.2 (GND), U19.3 (GND), U19.8 (GND), U20.3 (G), U20.8 (G), U21.3 (G), U21.8 (G), U22.3 (G), U22.8 (G), U23.3 (G), U23.8 (G), U24.2 (GND), U25.3 (G), U25.8 (G), U26.3 (GND), U26.8 (GND), U27.4 (GND)
GPIO0_D0: J15.10
HDMI0_CEC: J8.7, U19.5 (D2-), U19.6 (NC)
HDMI0_HOTPLUG: C73.2, J8.1, R32.2, U18.1 (I/O)
HDMI0_SBDN: C73.1
HDMI0_SBDP: C74.1
HDMI0_SBDP_cap: C74.2, J8.6, U19.4 (D2+), U19.7 (NC)
HDMI0_SCL_5V: J8.5, U19.2 (D1-), U19.9 (NC)
HDMI0_SDA_5V: J8.4, U19.1 (D1+), U19.10 (NC)
HDMI0_TX0+: C76.1
HDMI0_TX0-: C70.1
HDMI0_TX0_PORT+: C76.2, J8.13, U20.5 (IO4), U20.6 (NC)
HDMI0_TX0_PORT-: C70.2, J8.11, U20.4 (IO3), U20.7 (NC)
HDMI0_TX1+: C77.1
HDMI0_TX1-: C71.1
HDMI0_TX1_PORT+: C77.2, J8.16, U21.2 (IO2), U21.9 (NC)
HDMI0_TX1_PORT-: C71.2, J8.14, U21.1 (IO1), U21.10 (NC)
HDMI0_TX2+: C78.1
HDMI0_TX2-: C72.1
HDMI0_TX2_PORT+: C78.2, J8.19, U21.5 (IO4), U21.6 (NC)
HDMI0_TX2_PORT-: C72.2, J8.17, U21.4 (IO3), U21.7 (NC)
HDMI0_TX3+: C75.1
HDMI0_TX3-: C69.1
HDMI0_TX3_PORT+: C75.2, J8.10, U20.2 (IO2), U20.9 (NC)
HDMI0_TX3_PORT-: C69.2, J8.8, U20.1 (IO1), U20.10 (NC)
HP_INT: R29.2, U17.2 (~INT)
I2C6_SCL_M3: J16.3
I2C6_SDA_M3: J16.4
I2C7_SCL_M2: J10.11
I2C7_SDA_M2: J10.12
I2C8_SCL_M2: R31.1, U17.37 (SCL)
I2C8_SDA_M2: R30.1, U17.36 (SDA)
I2C_SCL_BAT_1V8: R37.1, U27.3 (A2)
I2C_SCL_BAT_3V3: J15.7, R39.1, U27.6 (B2)
I2C_SDA_BAT_1V8: R35.2, U27.2 (A1)
I2C_SDA_BAT_3V3: J15.8, R38.2, U27.7 (B1)
I2S0_LRCK_TX: U17.43 (ASP_LRCK/_FSYNC)
I2S0_SCLK_TX: U17.42 (ASP_SCLK/_SWIRE_CLK)
I2S0_SDI: U17.41 (ASP_SDOUT)
I2S0_SDO: U17.44 (ASP_SDIN/_SWIRE_SD)
unnamed: C79.2, U17.32 (FILT+)
unnamed: C84.1, U17.10 (+VCP_FILT)
unnamed: C85.1, U17.13 (–VCP_FILT)
unnamed: C86.1, U17.8 (FLYP)
unnamed: C86.2, C87.1, U17.9 (FLYC)
unnamed: C87.2, U17.11 (FLYN)
unnamed: C88.1, U17.22 (HSBIAS_FILT)
unnamed: C88.2, U17.23 (HSBIAS_FILT__REF)
unnamed: C95.1, C97.1, C98.1, D7.1 (K), D8.1 (K), J13.1, J14.1, U24.1 (OUT)
unnamed: J9.1, U17.14 (HPSENSA), U17.15 (HPOUTA)
unnamed: J9.2, U17.16 (HPOUTB), U17.17 (HPSENSB)
unnamed: J9.3, J9.4, U17.19 (HS3_REF), U17.21 (RING_SENSE), U17.24 (HS3), U17.26 (HS_CLAMP1), U17.30 (HSIN–)
unnamed: J9.5, U17.20 (HS4_REF), U17.27 (HS_CLAMP2), U17.28 (HS4), U17.29 (HSIN+)
unnamed: R36.2, U24.4 (~EN)
PHY_MDI0+: J7.20, U14.1 (D1+), U14.10 (NC)
PHY_MDI0-: J7.19, U14.2 (D1-), U14.9 (NC)
PHY_MDI1+: J7.14, U14.5 (D2-), U14.6 (NC)
PHY_MDI1-: J7.15, U14.4 (D2+), U14.7 (NC)
PHY_MDI2+: J7.11, U15.1 (D1+), U15.10 (NC)
PHY_MDI2-: J7.10, U15.2 (D1-), U15.9 (NC)
PHY_MDI3+: J7.7, U15.4 (D2+), U15.7 (NC)
PHY_MDI3-: J7.6, U15.5 (D2-), U15.6 (NC)
PWM4_M0: J15.4
PWM11_M3: J16.2
PWM15_M1: J15.9
PWRON_L: J15.2
RESET_L: J17.1
SARADC_VIN0_BOOT: J15.3
SARADC_VIN1_RECOVERY: J16.1
SD_CLK: R34.2
SD_CLK_con: J11.5 (CLK), R34.1, U23.1 (IO1), U23.10 (NC)
SD_CMD: J11.3 (CMD), U22.5 (IO4), U22.6 (NC)
SD_DAT0: J11.7 (DAT0), U23.2 (IO2), U23.9 (NC)
SD_DAT1: J11.8 (DAT1), U23.4 (IO3), U23.7 (NC)
SD_DAT2: J11.1 (DAT2), U22.2 (IO2), U22.9 (NC)
SD_DAT3: J11.2 (DAT3/CD), U22.4 (IO3), U22.7 (NC)
SD_DET_L: J11.9 (DET), R33.1, U23.5 (IO4), U23.6 (NC)
SPI0_CLK_M1: J17.5
SPI0_CS0_M1: J17.3
SPI0_MISO_M1: J17.2
SPI0_MOSI_M1: J17.4
TYPEC0_SBU1: J18.10
TYPEC0_SBU2: J18.9
TYPEC0_SSRX1N: J18.7
TYPEC0_SSRX1P: J18.8
TYPEC0_SSRX2N: J18.3
TYPEC0_SSRX2P: J18.4
TYPEC0_SSTX1N: C102.1
TYPEC0_SSTX1P: C100.1
TYPEC0_SSTX1_con+: C100.2, J18.6
TYPEC0_SSTX1_con-: C102.2, J18.5
TYPEC0_SSTX2N: C101.1
TYPEC0_SSTX2P: C99.1
TYPEC0_SSTX2_con+: C99.2, J18.2
TYPEC0_SSTX2_con-: C101.2, J18.1
UART2_RX: J15.6
UART2_TX: J15.5
USB2_HOST_AUX0_D+: J13.2, U25.2 (IO2), U25.9 (NC)
USB2_HOST_AUX0_D-: J13.3, U25.1 (IO1), U25.10 (NC)
USB2_HOST_AUX1_D+: J14.2, U25.5 (IO4), U25.6 (NC)
USB2_HOST_AUX1_D-: J14.3, U25.4 (IO3), U25.7 (NC)
USB_5V_PWREN_H: R36.1
USB_OTG_D+: J12.3, U26.2 (D1-), U26.9 (NC)
USB_OTG_D-: J12.4, U26.1 (D1+), U26.10 (NC)
USB_OTG_ID: J12.2, U26.4 (D2+), U26.7 (NC)
VCCIO_FLASH: R33.2
~RESET_CODEC: U17.1 (~RESET)

Notes on the sheet:
Source Pull-up resistors for SCL and SDA signals = 1.5...2kOhm
3.3V
USB HOST AUX
Vf@50mA=300mV. Vsup.min=4.8V Problems
Sink Pull-up resistors for SCL signal = 47k ohms, +/-10%
CODEC
TSTI - Connect to GNDA
MDI pairs are impedance-controlled balanced differential pairs (Z0 = 100 Ω)
Hot Plug Detect Signal (HPD) High voltage level (Source) = 2...5.3V
1mA
VL_SEL - Connect to VP for 1.8-V VL supply, connect to GNDD for 1.2-V VL supply
SCL clock frequency (MAX) = 1000kHz
ETHERNET PHY
VCCA≤VCCB
For adjacent signal pairs and shield traces make distance d ≥ 3 s
через TVS?
500mA
HDMI
10mA
USB OTG
47uF?(unification)
To avoid unwanted coupling into the modulators, all signals, especially clocks, must be isolated from the FILT+ pin. •The FILT+ capacitor close to GNDA. •The +VCP_FILT and –VCP_FILT capacitors close to GNDCP.
GPIO
Differential Impedance HEAC+/- = 100 ohms
max 200mA
The SDMMC_DET_L(J1‑74 Pin) needs to be pulled down by default if booting from microSD is required
microSD
anti-pad diameter for vias on any high-speed signal are as large as possible (30 mils provides significant benefits without imposing undue implementation hardship). The copper clearance, indicated by this anti-pad, must be met on all layers where the via exists, including both routing layer and pla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
WAKE - outputs the state of the Mic S0 or HP wake detect
3.0...5.25V
VCP=1.66...1.94V
HDMI_TX0_HPD(U13B‑153 Pin) is connected directly to the HDMI con‑ nector without any processing due to the step‑down processing on the Radxa CM5
Pull up the CMD pin to VCC. Pull up the CD pin to VCC. Pull up the WP pin to VCC. No pull-up or pull-down for the DAT pins unless specified.
Vf@60mA=310mV. Vsup=3...5.5V
Guidelines for PCB Signal Lines of MIPI-CSI and MIPI-DSI Line impedance √: Differential 100Ω ± 20% Line length difference Between Diff. Clock and Diff.Data √: As same length as possible √: Line length is as short as possible Between each pos. and neg. Line bending Recommended: External angle 45° (P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
SCLK operation below 2.8224 MHz may result in degraded performance.
Differential Impedance = 100 ohms
2.5...3.63V (HDMIspec1.4b)
DSI LCD
