Shisius/EyeMeterPCB/Interface/list3.kicad_sch

## KiCad design Interface/list3.kicad_sch (2025-08-15)

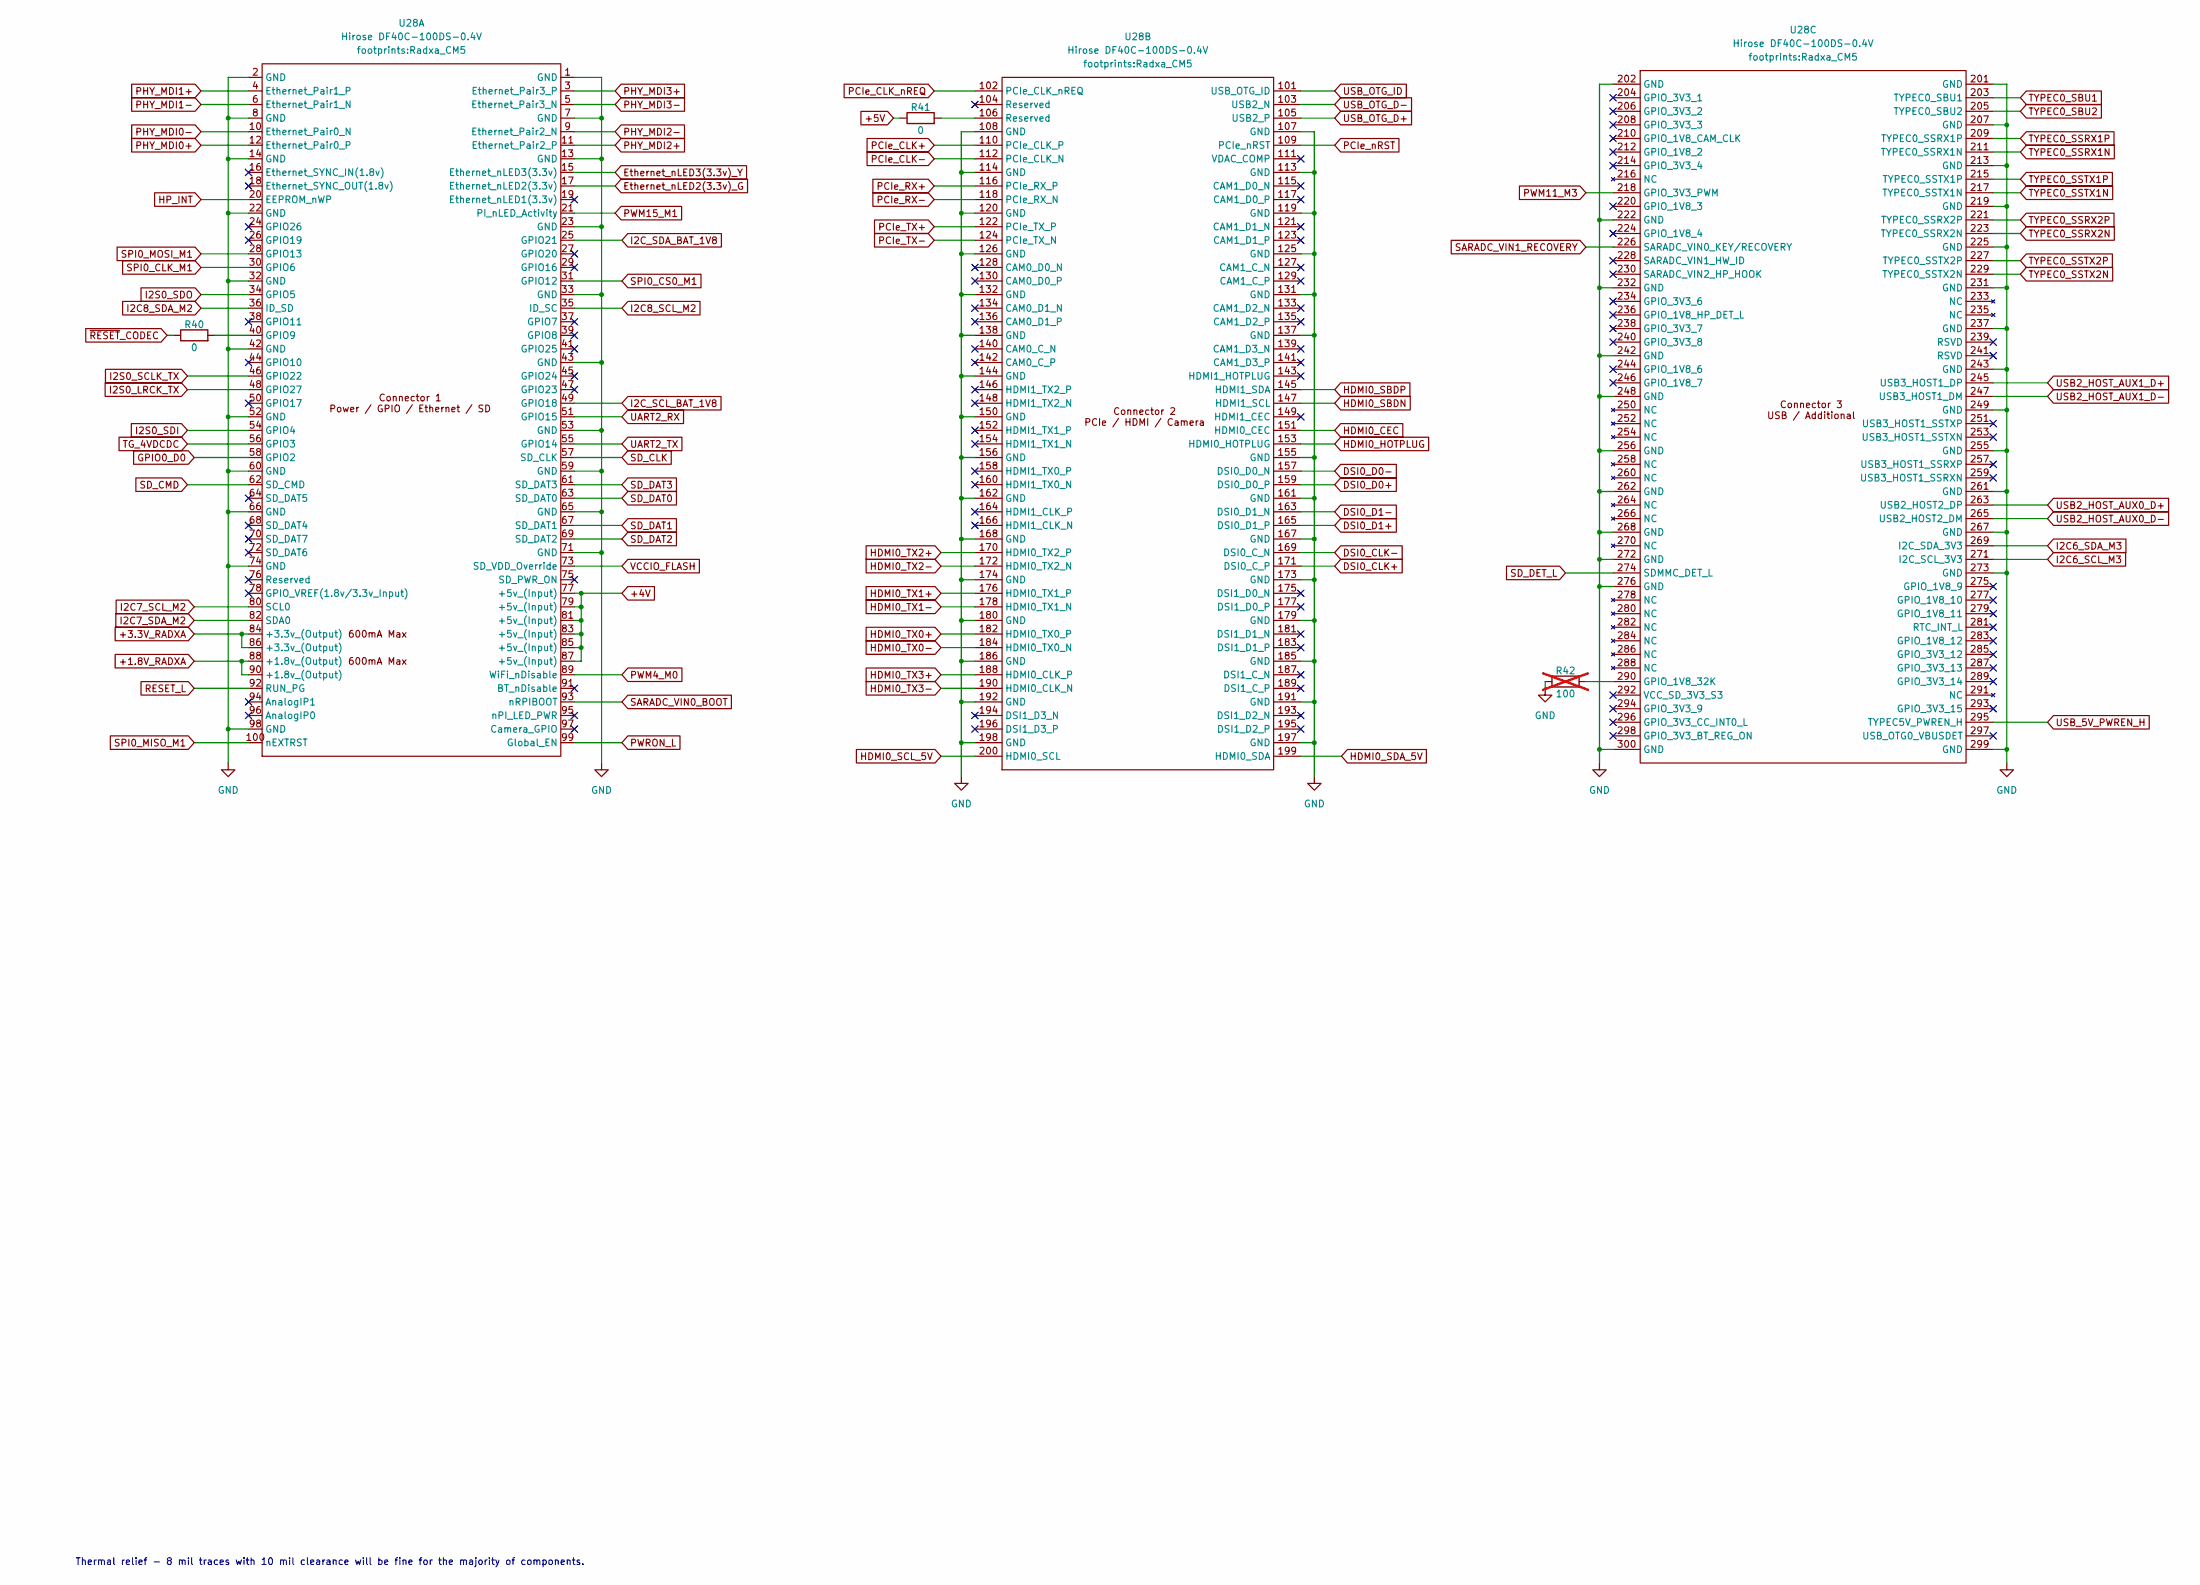
[picture p5: schematic list3.kicad_sch]

Parts:
R40: 0; R_0402_1005Metric_Pad0.72x0.64mm_HandSolder
R41: 0; R_0603_1608Metric_Pad0.98x0.95mm_HandSolder
R42: 100; R_0402_1005Metric_Pad0.72x0.64mm_HandSolder; not fitted
U28: Hirose DF40C-100DS-0.4V; Radxa_CM5

Connections:
+1.8V_RADXA: U28.88 (+1.8v_(Output)), U28.90 (+1.8v_(Output))
+3.3V_RADXA: U28.84 (+3.3v_(Output)), U28.86 (+3.3v_(Output))
+4V: U28.77 (+5v_(Input)), U28.79 (+5v_(Input)), U28.81 (+5v_(Input)), U28.83 (+5v_(Input)), U28.85 (+5v_(Input)), U28.87 (+5v_(Input))
+5V: R41.1
DSI0_CLK+: U28.171 (DSI0_C_P)
DSI0_CLK-: U28.169 (DSI0_C_N)
DSI0_D0+: U28.159 (DSI0_D0_P)
DSI0_D0-: U28.157 (DSI0_D0_N)
DSI0_D1+: U28.165 (DSI0_D1_P)
DSI0_D1-: U28.163 (DSI0_D1_N)
Ethernet_nLED2(3.3v)_G: U28.17 (Ethernet_nLED2(3.3v))
Ethernet_nLED3(3.3v)_Y: U28.15 (Ethernet_nLED3(3.3v))
GND: R42.1, U28.1 (GND), U28.2 (GND), U28.7 (GND), U28.8 (GND), U28.13 (GND), U28.14 (GND), U28.22 (GND), U28.23 (GND), U28.32 (GND), U28.33 (GND), U28.42 (GND), U28.43 (GND), U28.52 (GND), U28.53 (GND), U28.59 (GND), U28.60 (GND), U28.65 (GND), U28.66 (GND), U28.71 (GND), U28.74 (GND), U28.98 (GND), U28.107 (GND), U28.108 (GND), U28.113 (GND), U28.114 (GND), U28.119 (GND), U28.120 (GND), U28.125 (GND), U28.126 (GND), U28.131 (GND), U28.132 (GND), U28.137 (GND), U28.138 (GND), U28.144 (GND), U28.150 (GND), U28.155 (GND), U28.156 (GND), U28.161 (GND), U28.162 (GND), U28.167 (GND), U28.168 (GND), U28.173 (GND), U28.174 (GND), U28.179 (GND), U28.180 (GND), U28.185 (GND), U28.186 (GND), U28.191 (GND), U28.192 (GND), U28.197 (GND), U28.198 (GND), U28.201 (GND), U28.202 (GND), U28.207 (GND), U28.213 (GND), U28.219 (GND), U28.222 (GND), U28.225 (GND), U28.231 (GND), U28.232 (GND), U28.237 (GND), U28.242 (GND), U28.243 (GND), U28.248 (GND), U28.249 (GND), U28.255 (GND), U28.256 (GND), U28.261 (GND), U28.262 (GND), U28.267 (GND), U28.268 (GND), U28.272 (GND), U28.273 (GND), U28.276 (GND), U28.299 (GND), U28.300 (GND)
GPIO0_D0: U28.58 (GPIO2)
HDMI0_CEC: U28.151 (HDMI0_CEC)
HDMI0_HOTPLUG: U28.153 (HDMI0_HOTPLUG)
HDMI0_SBDN: U28.147 (HDMI1_SCL)
HDMI0_SBDP: U28.145 (HDMI1_SDA)
HDMI0_SCL_5V: U28.200 (HDMI0_SCL)
HDMI0_SDA_5V: U28.199 (HDMI0_SDA)
HDMI0_TX0+: U28.182 (HDMI0_TX0_P)
HDMI0_TX0-: U28.184 (HDMI0_TX0_N)
HDMI0_TX1+: U28.176 (HDMI0_TX1_P)
HDMI0_TX1-: U28.178 (HDMI0_TX1_N)
HDMI0_TX2+: U28.170 (HDMI0_TX2_P)
HDMI0_TX2-: U28.172 (HDMI0_TX2_N)
HDMI0_TX3+: U28.188 (HDMI0_CLK_P)
HDMI0_TX3-: U28.190 (HDMI0_CLK_N)
HP_INT: U28.20 (EEPROM_nWP)
I2C6_SCL_M3: U28.271 (I2C_SCL_3V3)
I2C6_SDA_M3: U28.269 (I2C_SDA_3V3)
I2C7_SCL_M2: U28.80 (SCL0)
I2C7_SDA_M2: U28.82 (SDA0)
I2C8_SCL_M2: U28.35 (ID_SC)
I2C8_SDA_M2: U28.36 (ID_SD)
I2C_SCL_BAT_1V8: U28.49 (GPIO18)
I2C_SDA_BAT_1V8: U28.25 (GPIO21)
I2S0_LRCK_TX: U28.48 (GPIO27)
I2S0_SCLK_TX: U28.46 (GPIO22)
I2S0_SDI: U28.54 (GPIO4)
I2S0_SDO: U28.34 (GPIO5)
unnamed: R40.2, U28.40 (GPIO9)
unnamed: R41.2, U28.106 (Reserved)
unnamed: R42.2, U28.290 (GPIO_1V8_32K)
PCIe_CLK+: U28.110 (PCIe_CLK_P)
PCIe_CLK-: U28.112 (PCIe_CLK_N)
PCIe_CLK_nREQ: U28.102 (PCIe_CLK_nREQ)
PCIe_RX+: U28.116 (PCIe_RX_P)
PCIe_RX-: U28.118 (PCIe_RX_N)
PCIe_TX+: U28.122 (PCIe_TX_P)
PCIe_TX-: U28.124 (PCIe_TX_N)
PCIe_nRST: U28.109 (PCIe_nRST)
PHY_MDI0+: U28.12 (Ethernet_Pair0_P)
PHY_MDI0-: U28.10 (Ethernet_Pair0_N)
PHY_MDI1+: U28.4 (Ethernet_Pair1_P)
PHY_MDI1-: U28.6 (Ethernet_Pair1_N)
PHY_MDI2+: U28.11 (Ethernet_Pair2_P)
PHY_MDI2-: U28.9 (Ethernet_Pair2_N)
PHY_MDI3+: U28.3 (Ethernet_Pair3_P)
PHY_MDI3-: U28.5 (Ethernet_Pair3_N)
PWM4_M0: U28.89 (WiFi_nDisable)
PWM11_M3: U28.218 (GPIO_3V3_PWM)
PWM15_M1: U28.21 (PI_nLED_Activity)
PWRON_L: U28.99 (Global_EN)
RESET_L: U28.92 (RUN_PG)
SARADC_VIN0_BOOT: U28.93 (nRPIBOOT)
SARADC_VIN1_RECOVERY: U28.226 (SARADC_VIN0_KEY/RECOVERY)
SD_CLK: U28.57 (SD_CLK)
SD_CMD: U28.62 (SD_CMD)
SD_DAT0: U28.63 (SD_DAT0)
SD_DAT1: U28.67 (SD_DAT1)
SD_DAT2: U28.69 (SD_DAT2)
SD_DAT3: U28.61 (SD_DAT3)
SD_DET_L: U28.274 (SDMMC_DET_L)
SPI0_CLK_M1: U28.30 (GPIO6)
SPI0_CS0_M1: U28.31 (GPIO12)
SPI0_MISO_M1: U28.100 (nEXTRST)
SPI0_MOSI_M1: U28.28 (GPIO13)
TG_4VDCDC: U28.56 (GPIO3)
TYPEC0_SBU1: U28.203 (TYPEC0_SBU1)
TYPEC0_SBU2: U28.205 (TYPEC0_SBU2)
TYPEC0_SSRX1N: U28.211 (TYPEC0_SSRX1N)
TYPEC0_SSRX1P: U28.209 (TYPEC0_SSRX1P)
TYPEC0_SSRX2N: U28.223 (TYPEC0_SSRX2N)
TYPEC0_SSRX2P: U28.221 (TYPEC0_SSRX2P)
TYPEC0_SSTX1N: U28.217 (TYPEC0_SSTX1N)
TYPEC0_SSTX1P: U28.215 (TYPEC0_SSTX1P)
TYPEC0_SSTX2N: U28.229 (TYPEC0_SSTX2N)
TYPEC0_SSTX2P: U28.227 (TYPEC0_SSTX2P)
UART2_RX: U28.51 (GPIO15)
UART2_TX: U28.55 (GPIO14)
USB2_HOST_AUX0_D+: U28.263 (USB2_HOST2_DP)
USB2_HOST_AUX0_D-: U28.265 (USB2_HOST2_DM)
USB2_HOST_AUX1_D+: U28.245 (USB3_HOST1_DP)
USB2_HOST_AUX1_D-: U28.247 (USB3_HOST1_DM)
USB_5V_PWREN_H: U28.295 (TYPEC5V_PWREN_H)
USB_OTG_D+: U28.105 (USB2_P)
USB_OTG_D-: U28.103 (USB2_N)
USB_OTG_ID: U28.101 (USB_OTG_ID)
VCCIO_FLASH: U28.73 (SD_VDD_Override)
~RESET_CODEC: R40.1

Notes on the sheet:
Thermal relief - 8 mil traces with 10 mil clearance will be fine for the majority of components.
